iledesma08/PIC16F887-WaterCooling/(list of files, drawings)

Other design files:
Sim.pdsprj
