iledesma08/PIC16F887-WaterCooling/(commit log)

2024-06-11 Assemblyv1
    Multiplexado logrado. BUG: cada 4 rotaciones del PORTB, es como si se hiciera una rotacion adicional
    [TP.asm]
2024-06-11 Assemblyv2
    Lograda la activacion de los perifericos segun la temperatura de referencia y se muestra la temperatura actual en el display
2024-06-11 Assemblyv3
    Lograda la comunicacion en serie
2024-06-11 Script de Python para comunicacion en serie
    Muestra la temperatura recibida por transmision en serie
2024-06-13 v3.1
    + Se hicieron cambios en los comentarios para dar mayor comprension
    + La comunicacion en serie transmite la temperatura de referencia (TO DO: deberia hacerlo cuando se cambia, no durante la interrupcion del Timer1)
    + Los displays muestran "HI" al iniciar el sistema
    + Se configuró para hacer interrupcion por cambios en PORTB, pero Proteus tira error cuando eso pasa
    [main.asm]
2024-06-13 v3.1
    + El nombre del archivo paso de TP a main
    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
    [main.asm]
2024-06-13 v2
    + Se establece COM3 como puerto de Comunicacion en serie (al usar adaptador DB9 a USB y conectarlo a una PC con Windows 10, utiliza ese puerto)
2024-06-14 v4
    + Implementado el ingreso por teclado de la temperatura de referencia
    + La comunicacion en serie se hace en 2 momentos: la primera vez durante la interrupcion del Timer1, y de ahi en adelante solamente al cambiar el valor de la temperatura de referencia por teclado
    + En el display se muestra el boton presionado, muestra el mensaje "Er" de erased cuando se presiona * y muestra la temperatura de referencia cuando se presiona #
2024-06-14 v1
    - Funcional, faltan las resistencias
    [Sim.pdsprj]
2024-06-17 release1
    + Reducido el tiempo de Timer0 a 6,67ms para mejorar la visualizacion en el display
    + Ahora el teclado espera por 1s y no por 0s (se implementan Resistencias de Pull-down en el circuito y esto se hace para poner transistores npn en los displays)
    + Se optimizó un poco más el codigo
2024-06-18 release2
    + Se ordenó un poco más el circuito
    + Se le agregaron etiquetas a algunos componentes
    [Sim.pdsprj]
